SebastianAntonioArcaVertiz/Balanza_digital_para_estacion_biomedica_con_comunicacion_i2c_arduino_nano_y_rasphberrypi5/DIAGRAMA DEL CIRCUITO.png

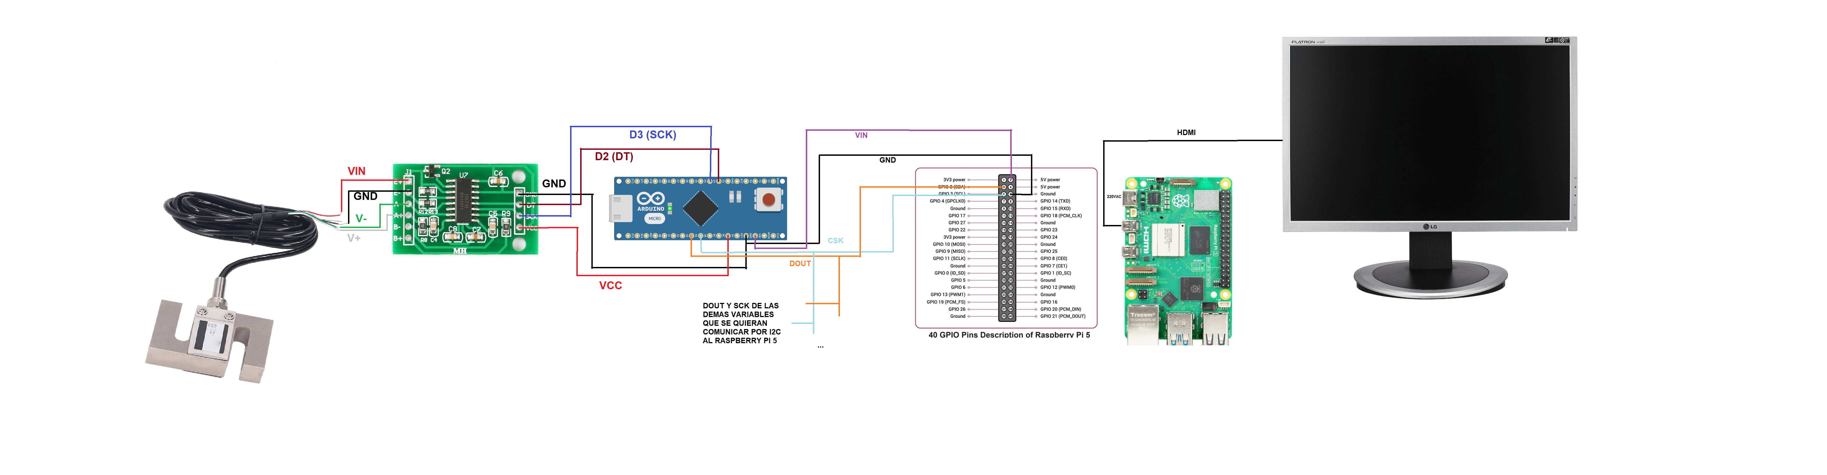
DIAGRAMA DEL CIRCUITO.png
